solarslurpi/GrowBuddies/README.md

# GrowBuddies
[Documentation Location](https://growbuddies.readthedocs.io/en/latest/)
