solarslurpi/GrowBuddies/drafts-docs in progress/notes.md

info: profile set to 'default'
info: default host triple is armv7-unknown-linux-gnueabihf
info: syncing channel updates for 'stable-armv7-unknown-linux-gnueabihf'
info: latest update on 2022-11-03, rust version 1.65.0 (897e37553 2022-11-02)
info: downloading component 'cargo'
info: downloading component 'clippy'
info: downloading component 'rust-docs'
 18.8 MiB /  18.8 MiB (100 %)  10.6 MiB/s in  3s ETA:  0s
info: downloading component 'rust-std'
 27.3 MiB /  27.3 MiB (100 %)  10.1 MiB/s in  3s ETA:  0s
info: downloading component 'rustc'
 79.0 MiB /  79.0 MiB (100 %)  10.6 MiB/s in  9s ETA:  0s
info: downloading component 'rustfmt'
info: installing component 'cargo'
  6.1 MiB /   6.1 MiB (100 %)   5.7 MiB/s in  1s ETA:  0s
info: installing component 'clippy'
info: installing component 'rust-docs'
 18.8 MiB /  18.8 MiB (100 %)   1.4 MiB/s in 19s ETA:  0s
info: installing component 'rust-std'
 27.3 MiB /  27.3 MiB (100 %)   5.3 MiB/s in  6s ETA:  0s
info: installing component 'rustc'
 79.0 MiB /  79.0 MiB (100 %)   5.7 MiB/s in 14s ETA:  0s
info: installing component 'rustfmt'
info: default toolchain set to 'stable-armv7-unknown-linux-gnueabihf'

  stable-armv7-unknown-linux-gnueabihf installed - rustc 1.65.0 (897e37553 2022-11-02)

Rust is installed now. Great!

To get started you may need to restart your current shell.
This would reload your PATH environment variable to include
Cargo's bin directory ($HOME/.cargo/bin).

To configure your current shell, run:
source "$HOME/.cargo/env"
