solarslurpi/GrowBuddies/docs/images/after_grow_additives.jpg

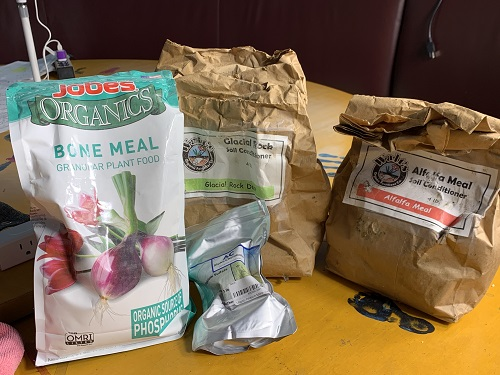
docs/images/after_grow_additives.jpg
