solarslurpi/GrowBuddies/docs/images/aliexpress12headmister.jpg

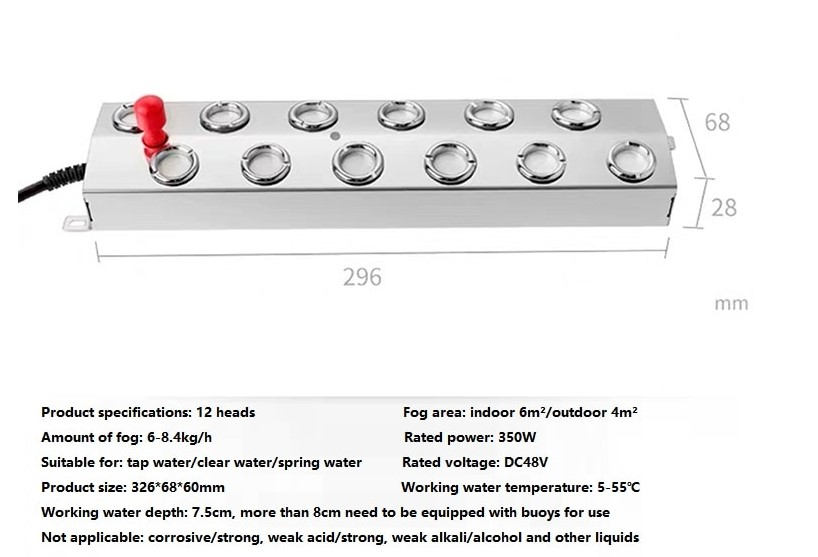
docs/images/aliexpress12headmister.jpg
