solarslurpi/GrowBuddies/docs/images/dragonfly.png

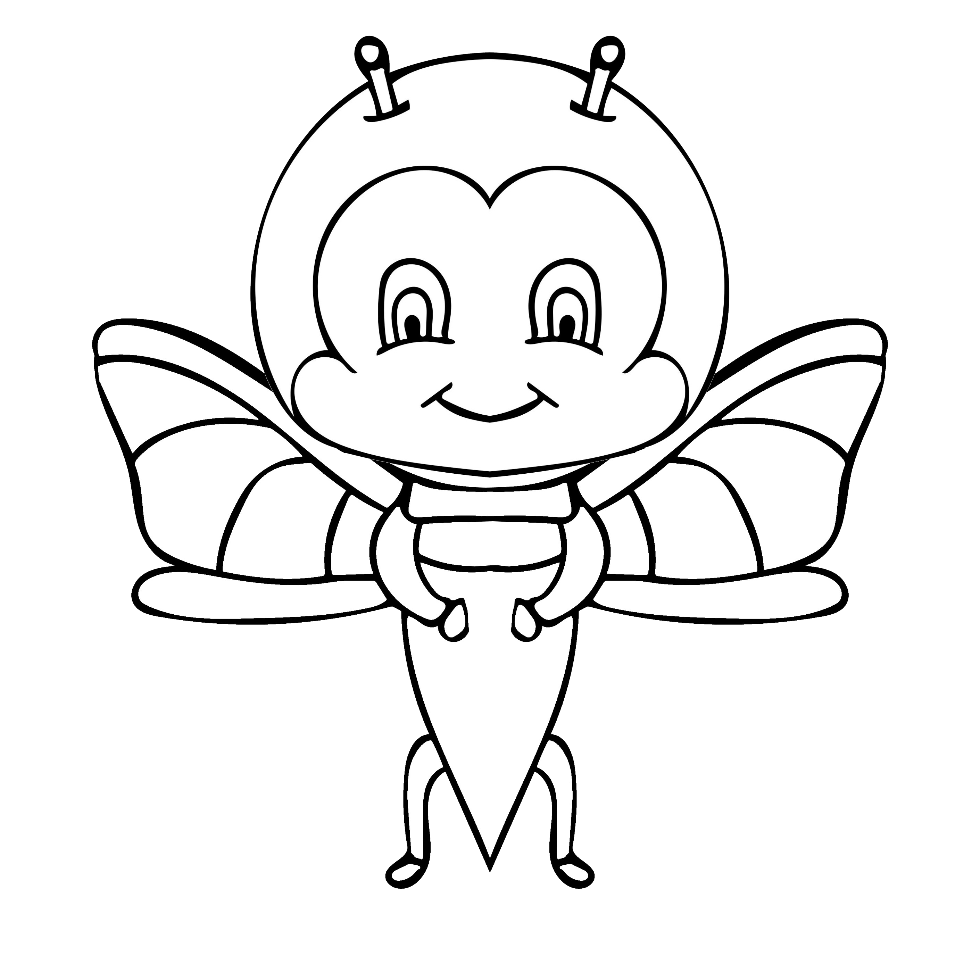
docs/images/dragonfly.png
