solarslurpi/GrowBuddies/docs/images/grafana_add_datasource.jpg

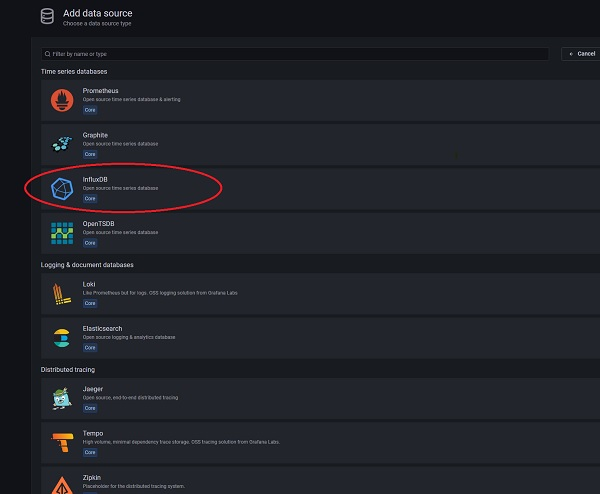
docs/images/grafana_add_datasource.jpg
