solarslurpi/GrowBuddies/docs/images/grafana_influxdb_http_config.jpg

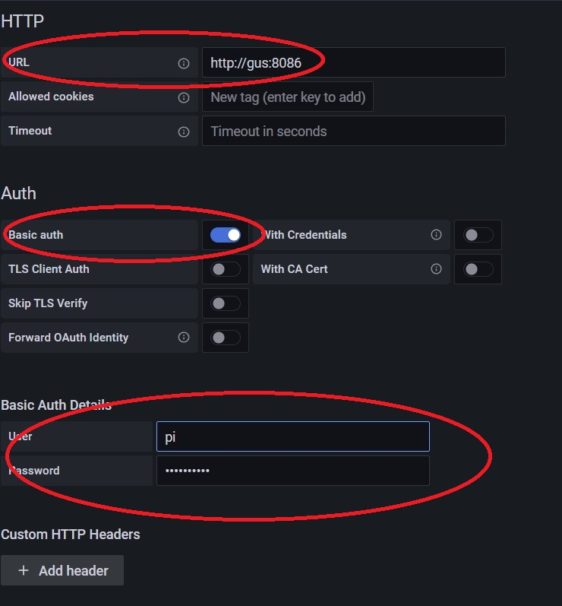
docs/images/grafana_influxdb_http_config.jpg
