solarslurpi/GrowBuddies/docs/images/grafana_influxdb_influxdb_config.jpg

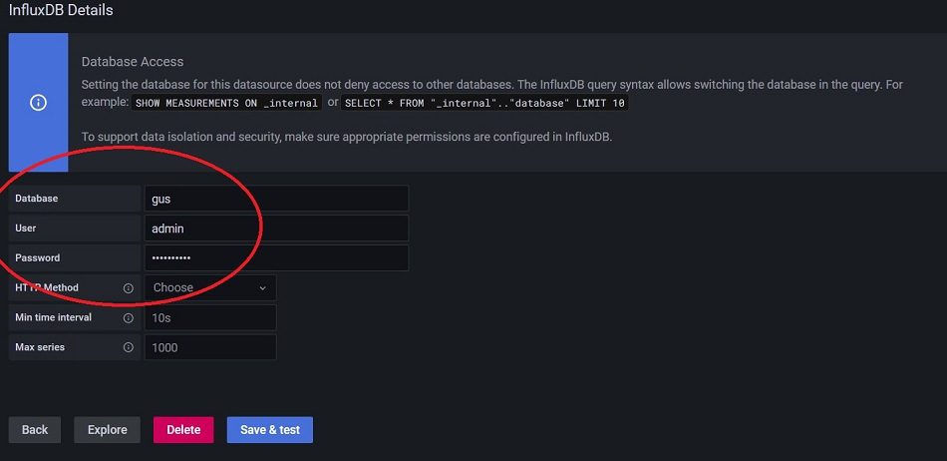
docs/images/grafana_influxdb_influxdb_config.jpg
