solarslurpi/GrowBuddies/docs/images/grafana_new_dashboard.jpg

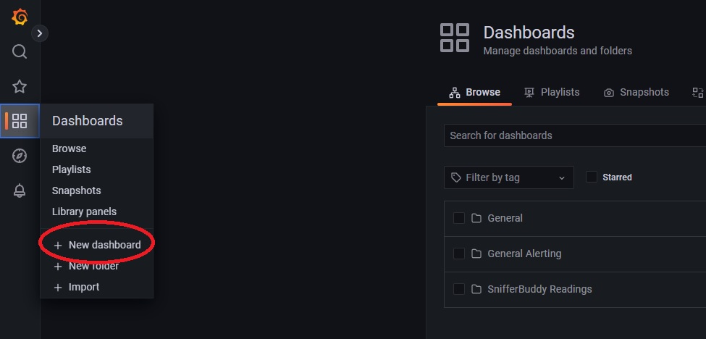
docs/images/grafana_new_dashboard.jpg
