solarslurpi/GrowBuddies/docs/images/grafana_snifferbuddyreadings_vpd._and_temp.jpg

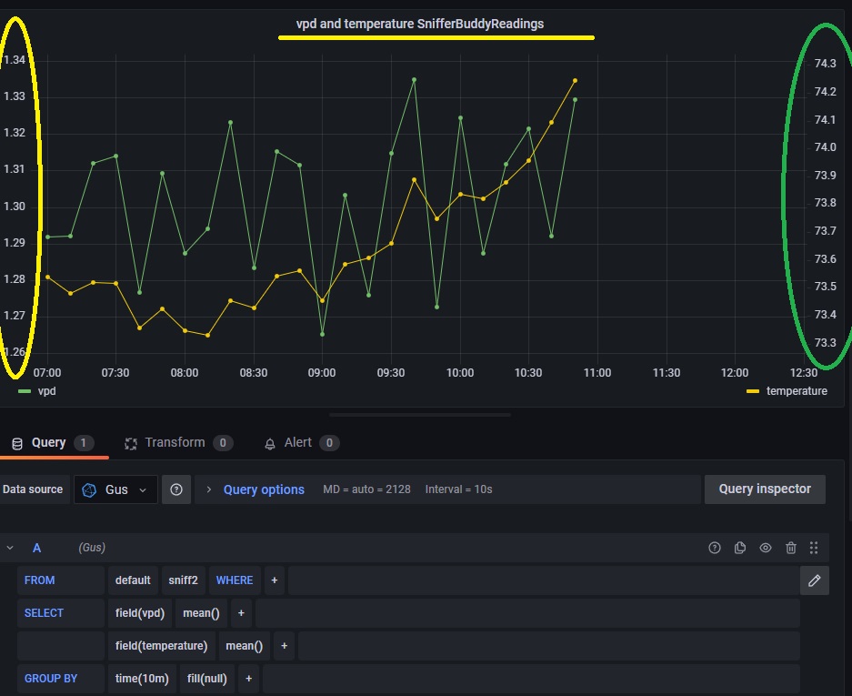
docs/images/grafana_snifferbuddyreadings_vpd._and_temp.jpg
