solarslurpi/GrowBuddies/docs/images/grafana_snifferbuddyreadings_vpd.jpg

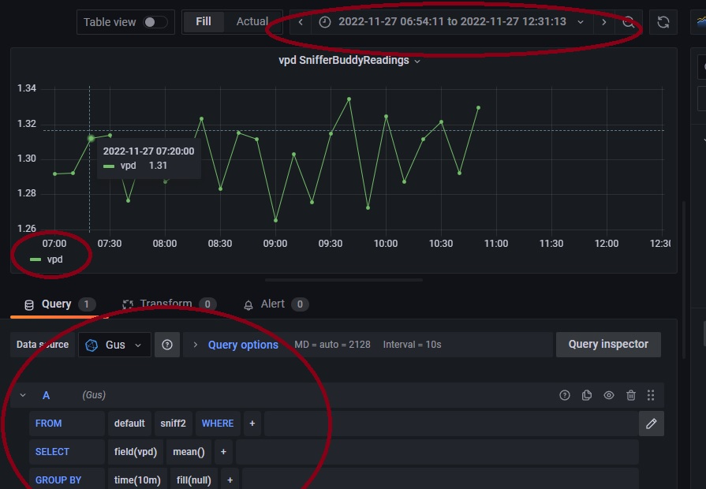
docs/images/grafana_snifferbuddyreadings_vpd.jpg
