solarslurpi/GrowBuddies/docs/images/hamster.jpg

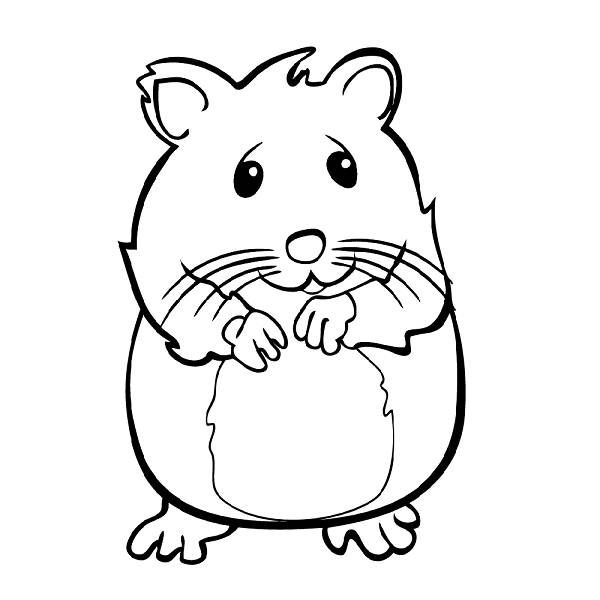
docs/images/hamster.jpg
