solarslurpi/GrowBuddies/docs/images/humidifier.jpeg

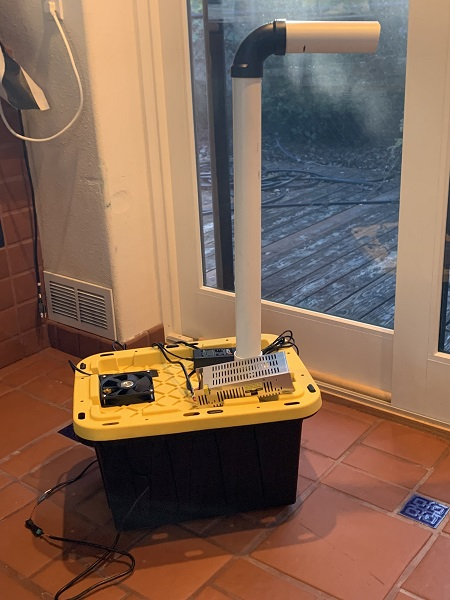
docs/images/humidifier.jpeg
