solarslurpi/GrowBuddies/docs/images/jobwelldone.jpg

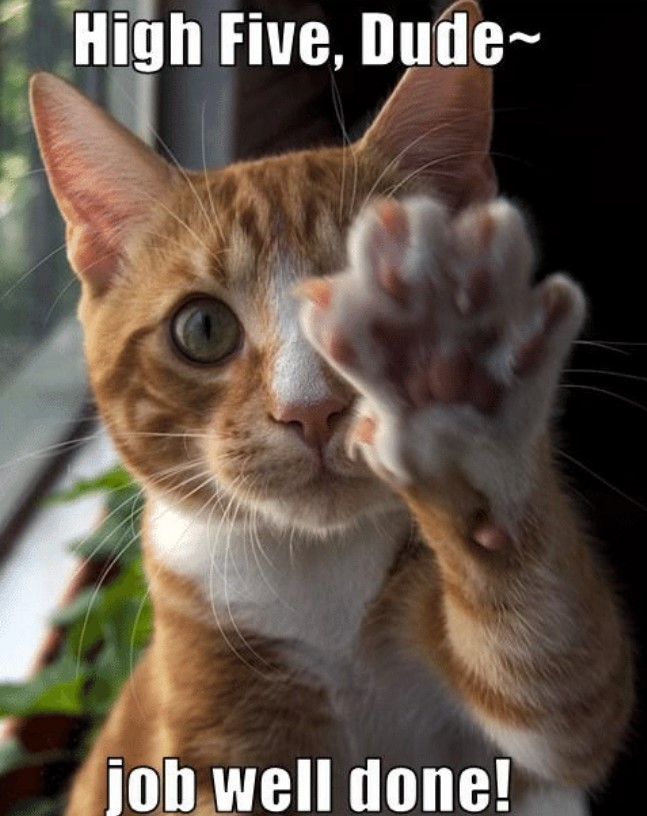
docs/images/jobwelldone.jpg
