solarslurpi/GrowBuddies/docs/images/MistBuddy_inside.jpeg

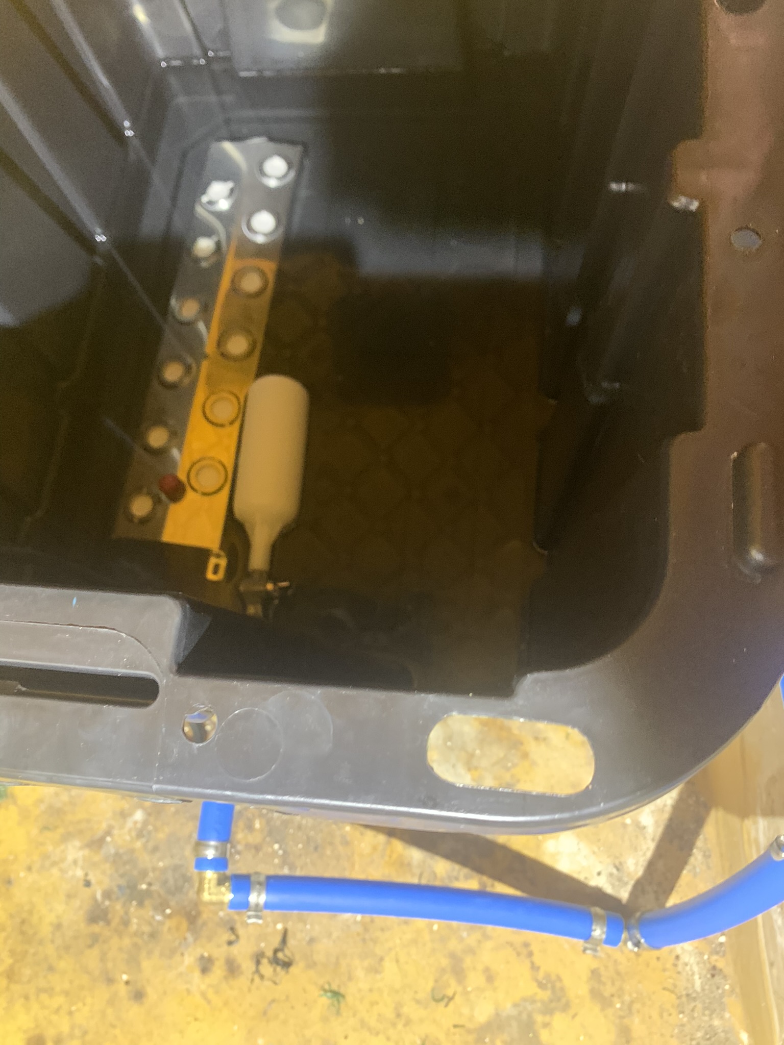
docs/images/MistBuddy_inside.jpeg
