solarslurpi/GrowBuddies/docs/images/mister_water_level.jpg

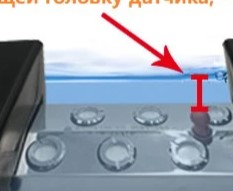
docs/images/mister_water_level.jpg
