solarslurpi/GrowBuddies/docs/images/plantvillage_classes_wheretofind.jpg

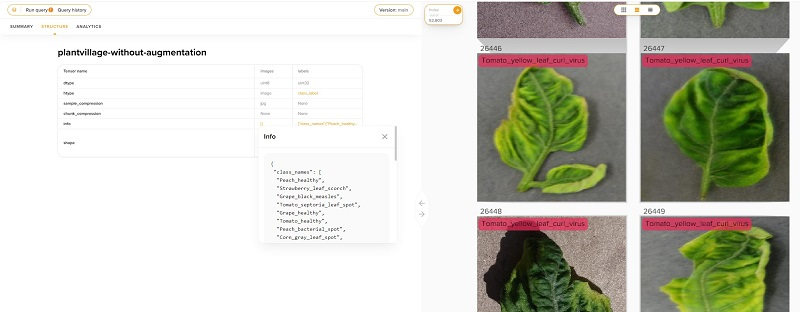
docs/images/plantvillage_classes_wheretofind.jpg
