solarslurpi/GrowBuddies/docs/images/power__supply.jpeg

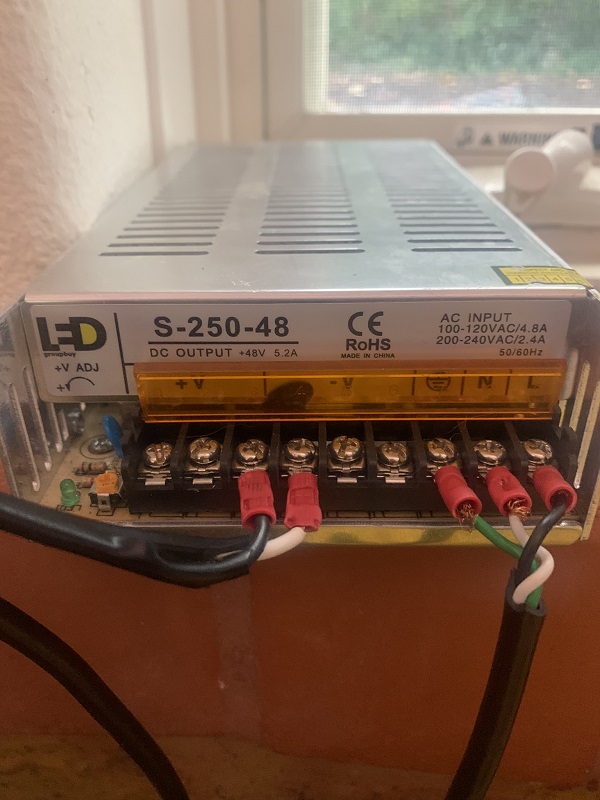
docs/images/power__supply.jpeg
