solarslurpi/GrowBuddies/docs/images/snifferbuddy_scd40_enclosure.jpg

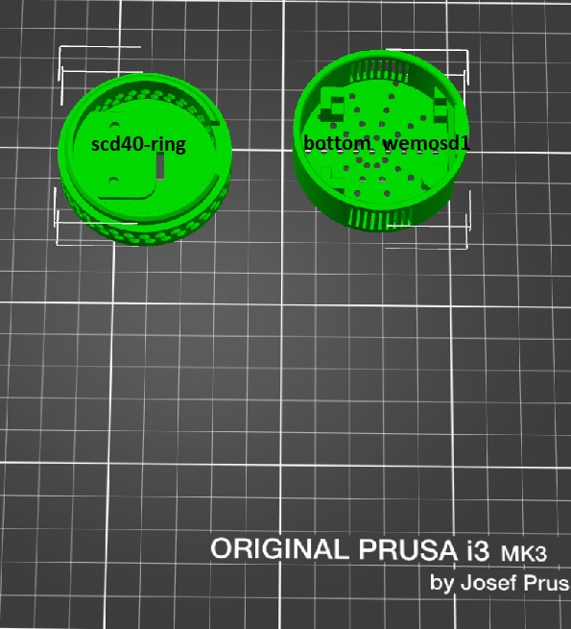
docs/images/snifferbuddy_scd40_enclosure.jpg
