solarslurpi/GrowBuddies/docs/images/snifferbuddy_scd40_inaction.jpg

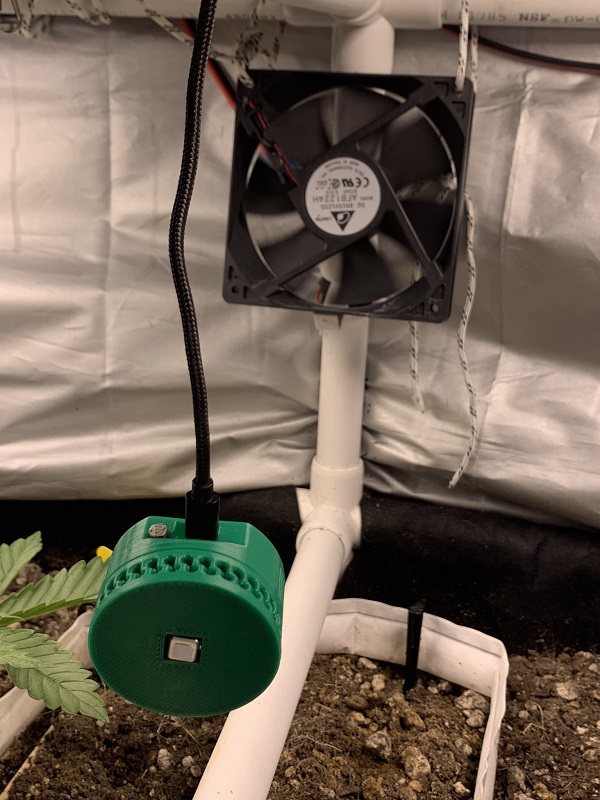
docs/images/snifferbuddy_scd40_inaction.jpg
