solarslurpi/GrowBuddies/docs/images/snifferbuddy_parts_on_printer_plate.jpg

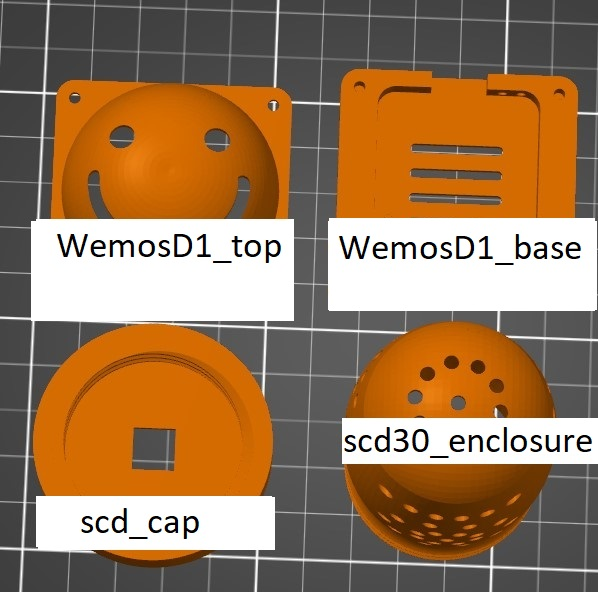
docs/images/snifferbuddy_parts_on_printer_plate.jpg
