solarslurpi/GrowBuddies/3D_prints/Gus/Pi4_Top_Hex_MM2_Color1.stl

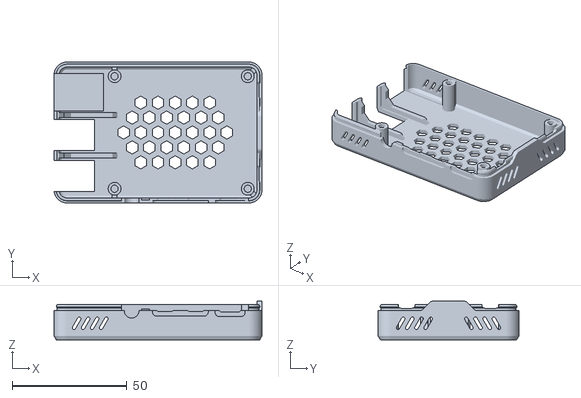
[picture p55: CAD file, 2022-10-26]
3D_prints/Gus/Pi4_Top_Hex_MM2_Color1.stl
90.6 x 61.4 x 16.9
