solarslurpi/GrowBuddies/3D_prints/PC Fan Holder/post (PART 2) v3.3mf

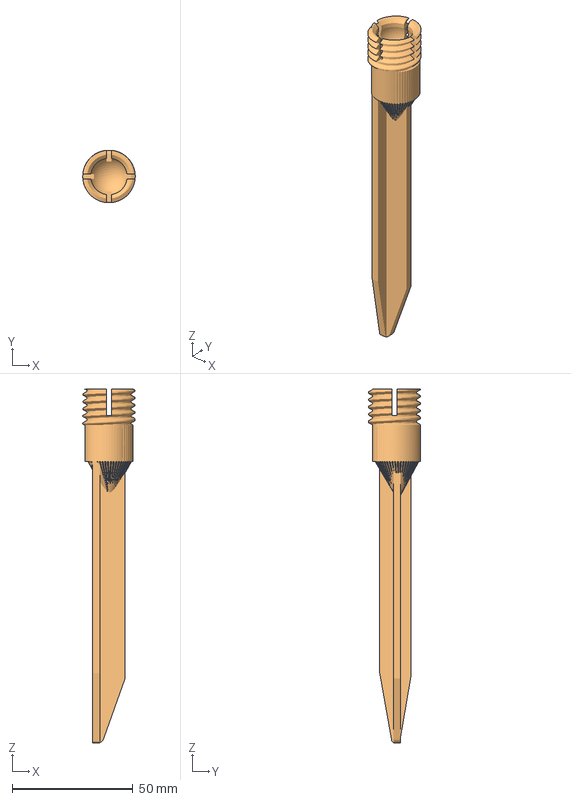
[picture p56: CAD file, 2024-07-01]
3D_prints/PC Fan Holder/post (PART 2) v3.3mf
21.8 x 21.8 x 146.8 mm
post-PART_2
tent post
