solarslurpi/GrowBuddies/3D_prints/SnifferBuddy/scd-30/wemosD1_base.3mf

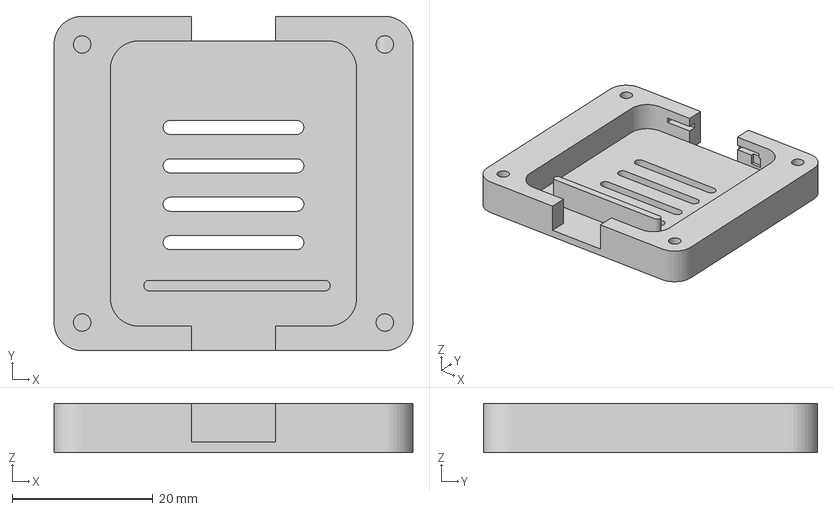
[picture p57: CAD file, 2022-10-20]
3D_prints/SnifferBuddy/scd-30/wemosD1_base.3mf
51.0 x 47.5 x 7.00 mm
