solarslurpi/GrowBuddies/3D_prints/SnifferBuddy/scd-40/wemos_bottom.3mf

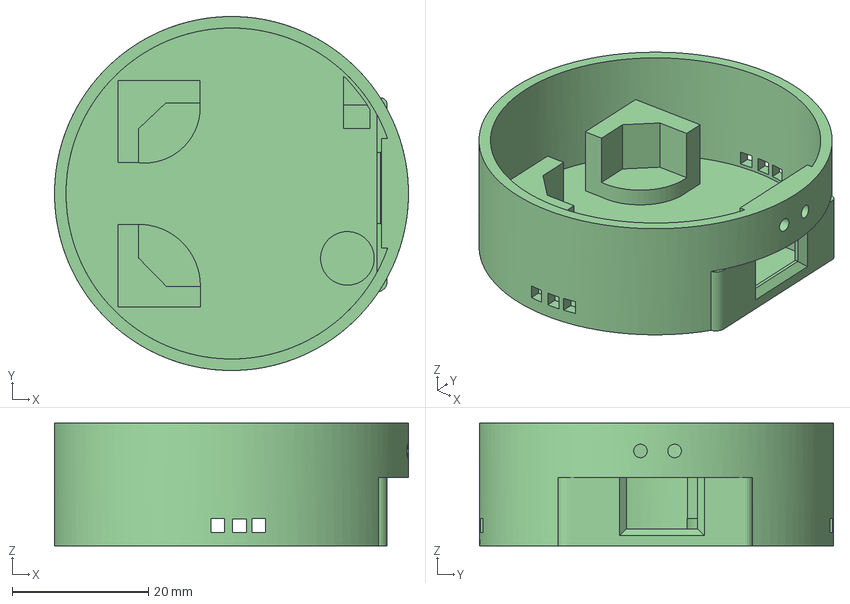
[picture p58: CAD file, 2023-11-12]
3D_prints/SnifferBuddy/scd-40/wemos_bottom.3mf
51.9 x 51.9 x 18.0 mm
