solarslurpi/GrowBuddies/3D_prints/Gus/Pi4_Top_Hex_MM2_Color2.stl

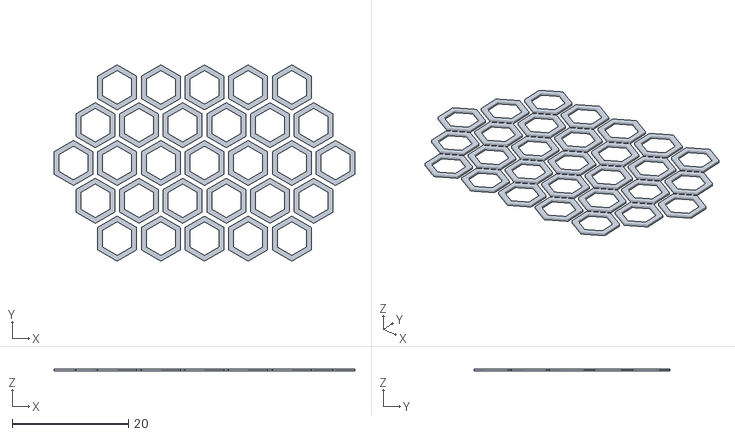
[picture p59: CAD file, 2022-10-26]
3D_prints/Gus/Pi4_Top_Hex_MM2_Color2.stl
51.7 x 33.7 x 0.4
