solarslurpi/GrowBuddies/3D_prints/SnifferBuddy/scd-30/scd_cap.3mf

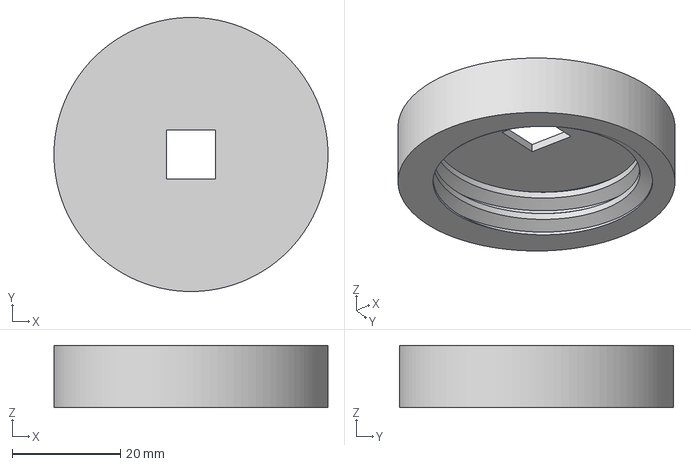
[picture p60: CAD file, 2022-10-19]
3D_prints/SnifferBuddy/scd-30/scd_cap.3mf
50.7 x 50.7 x 11.5 mm
