solarslurpi/GrowBuddies/3D_prints/Gus/Pi4_Bottom_Slots_SM.stl

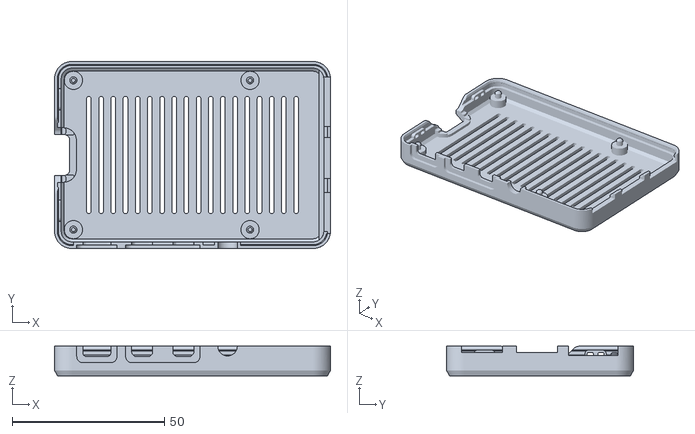
[picture p61: CAD file, 2022-10-26]
3D_prints/Gus/Pi4_Bottom_Slots_SM.stl
90.6 x 61.4 x 9.70
