solarslurpi/GrowBuddies/3D_prints/PC Fan Holder/fan_holder (PART 1) v2.3mf

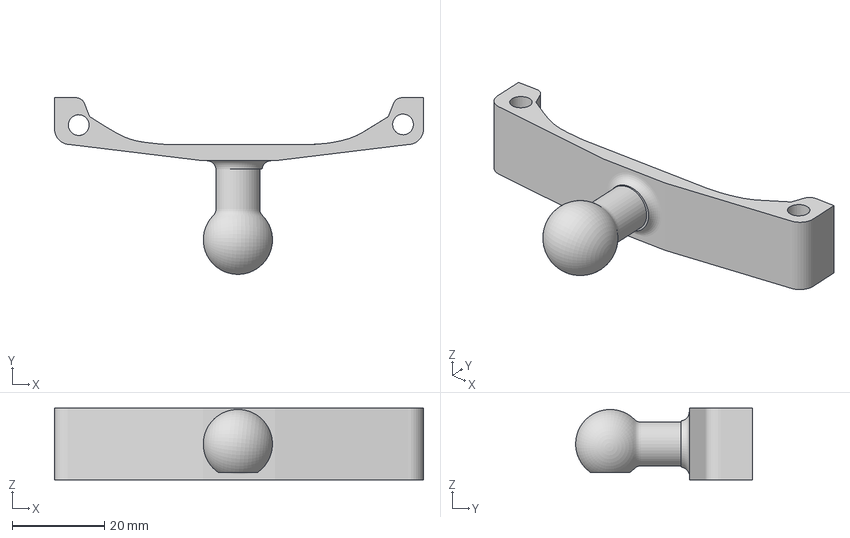
[picture p62: CAD file, 2024-07-01]
3D_prints/PC Fan Holder/fan_holder (PART 1) v2.3mf
80.0 x 38.3 x 15.5 mm
