solarslurpi/GrowBuddies/3D_prints/SnifferBuddy/scd-30/WemosD1_top.stl

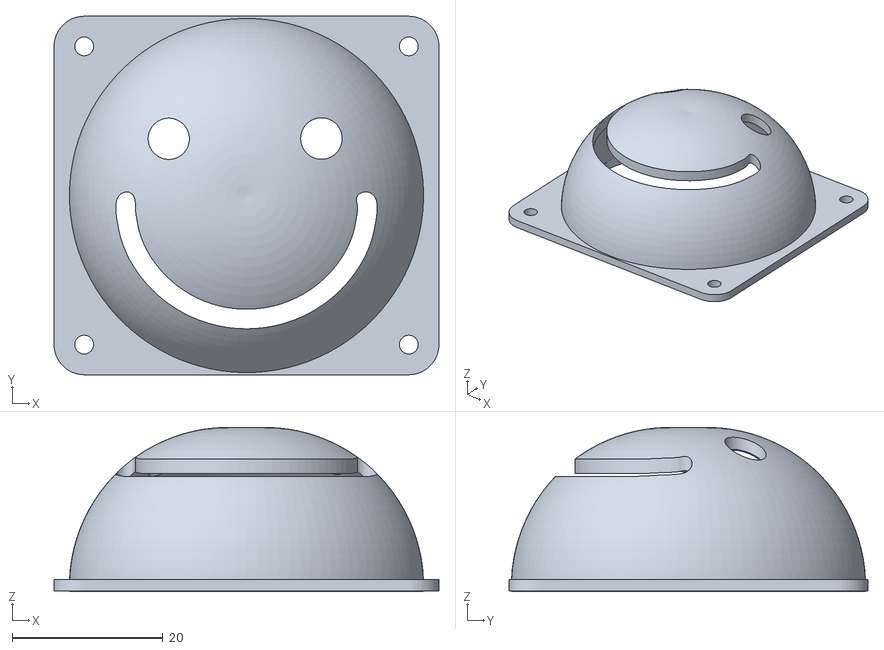
[picture p63: CAD file, 2022-10-07]
3D_prints/SnifferBuddy/scd-30/WemosD1_top.stl
51.0 x 47.5 x 21.8
