solarslurpi/GrowBuddies/3D_prints/Gus/Pi3_Top_Hex_MM2_Color1.stl

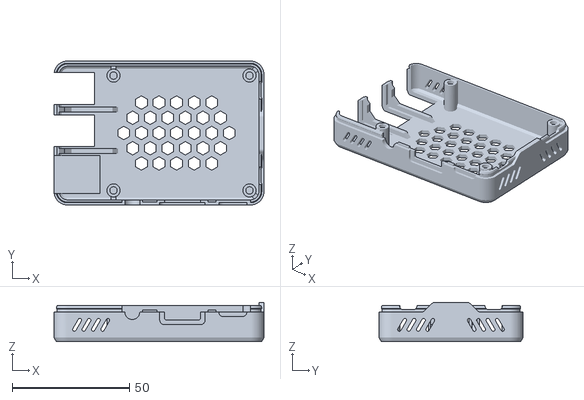
[picture p64: CAD file, 2022-10-25]
3D_prints/Gus/Pi3_Top_Hex_MM2_Color1.stl
89.6 x 61.4 x 16.9
