solarslurpi/GrowBuddies/3D_prints/SnifferBuddy/scd-30/scd30 enclosure.stl

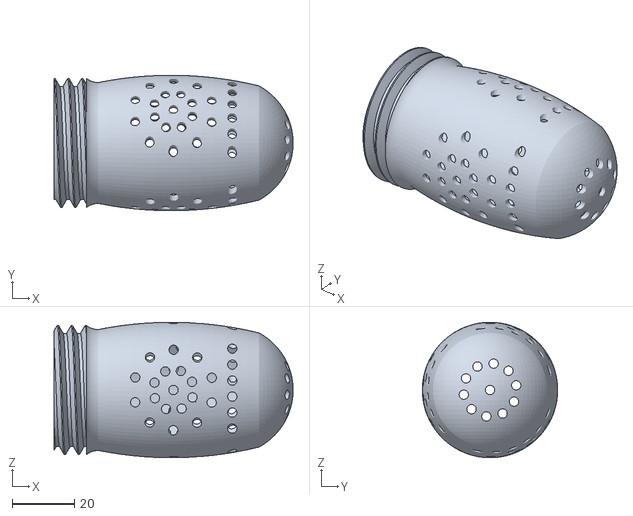
[picture p65: CAD file, 2022-10-07]
3D_prints/SnifferBuddy/scd-30/scd30 enclosure.stl
77.0 x 43.6 x 43.6
