solarslurpi/GrowBuddies/3D_prints/Gus/PI3_Bottom_Slots_SM.stl

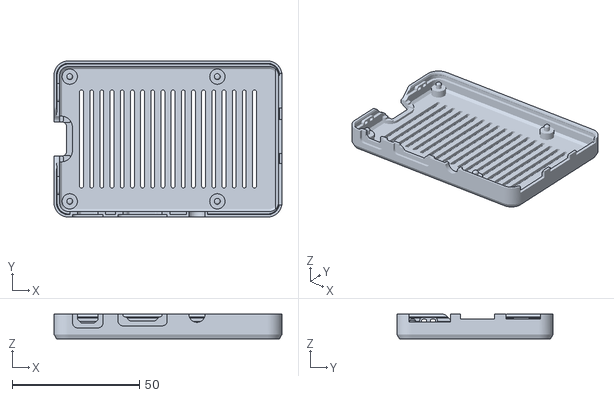
[picture p66: CAD file, 2022-10-25]
3D_prints/Gus/PI3_Bottom_Slots_SM.stl
89.6 x 61.4 x 9.70
