solarslurpi/GrowBuddies/3D_prints/PC Fan Holder/Nut (Part3).stl

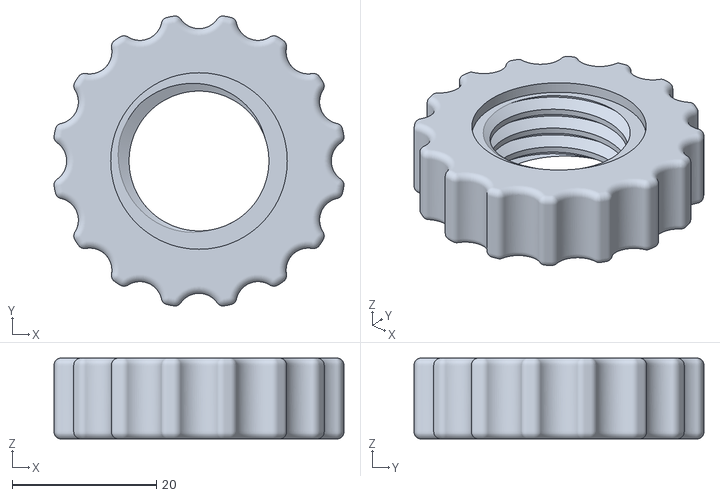
[picture p67: CAD file, 2024-07-01]
3D_prints/PC Fan Holder/Nut (Part3).stl
40.2 x 40.2 x 11.2
