solarslurpi/GrowBuddies/(list of files, cad)

Other CAD files:
3D_prints/Gus/Pi3_Top_Hex_MM2_Color2.stl
3D_prints/PC Fan Holder/fan_holder (PART 1) v2.f3d
3D_prints/SnifferBuddy/scd-30/WemosD1_base v2.f3z
3D_prints/SnifferBuddy/scd-30/WemosD1_top v1.f3d
3D_prints/SnifferBuddy/scd-30/_Wemos.8a6fa8fd-bdae-4608-9551-e9ac450bc9c8.f3d
3D_prints/SnifferBuddy/scd-30/scd cap v11.f3d
3D_prints/SnifferBuddy/scd-30/scd30 enclosure v1.f3d
3D_prints/SnifferBuddy/scd-40/wemos_top_v8.f3z
