solarslurpi/GrowBuddies/docs/images/snifferbuddy_scd40_wiring.jpg

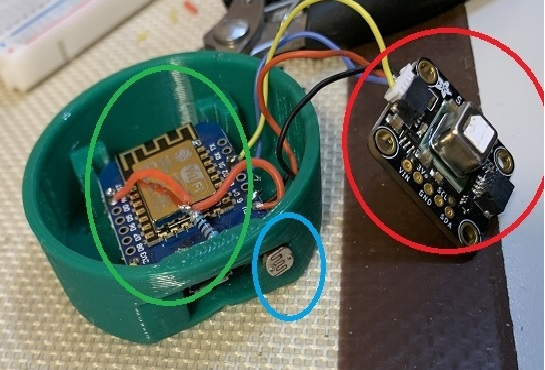
docs/images/snifferbuddy_scd40_wiring.jpg
