solarslurpi/GrowBuddies/growbuddiesproject/growbuddies/service_files/co2_tuning.csv

name | time | co2
co2_tuning | 1681327264873292426 | 1064
co2_tuning | 1681327294798611277 | 1015
co2_tuning | 1681327324829693850 | 925
co2_tuning | 1681327354812095681 | 950
co2_tuning | 1681327385077169976 | 1135
co2_tuning | 1681327414812701039 | 1177
co2_tuning | 1681327445021163627 | 1141
co2_tuning | 1681327474568743455 | 1074
co2_tuning | 1681327505001476845 | 969
co2_tuning | 1681327534799673376 | 883
co2_tuning | 1681327565017175346 | 849
co2_tuning | 1681327594842340758 | 763
co2_tuning | 1681327624821802002 | 739
co2_tuning | 1681327654767465010 | 724
co2_tuning | 1681327685017830676 | 707
co2_tuning | 1681327714824717395 | 730
co2_tuning | 1681327744781420928 | 674
co2_tuning | 1681327774570264674 | 678
co2_tuning | 1681327804795406670 | 695
co2_tuning | 1681327834564696316 | 745
co2_tuning | 1681327864796853379 | 863
co2_tuning | 1681327894930225467 | 1089
co2_tuning | 1681327924877700299 | 1115
co2_tuning | 1681327954884128572 | 1070
co2_tuning | 1681327984778132354 | 981
co2_tuning | 1681328014784849310 | 943
co2_tuning | 1681328045051205069 | 934
co2_tuning | 1681328074860957285 | 1072
co2_tuning | 1681328105077972155 | 1084
co2_tuning | 1681328134981905726 | 1005
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
