solarslurpi/GrowBuddies/docs/images/grafana_influxdb_data_test_worked.jpg

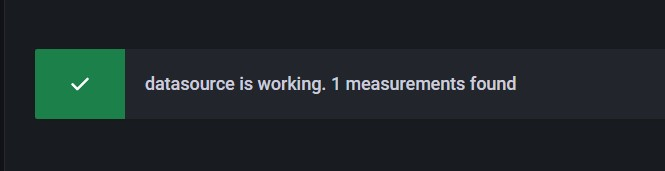
docs/images/grafana_influxdb_data_test_worked.jpg
