solarslurpi/GrowBuddies/(threads)

Thread 4 (2024-02-28):

PAR  and PPFF

latonita, 2024-02-28:
Hi, did you manage to calculate PAR and PPFD based on sensor AS7343 data?

clort81, 2024-07-08:
Been perusing the archive.org of his par_buddy and it looked pretty promising, really.
The 7343 could be a sensor that would yield a winner meter.
https://github.com/solarslurpi/GrowBuddy/blob/main/pages/PAR_Buddy.md

What happened to your jupyter notebooks and collected data solarslurpi?

It might also be possible to take a single diode LED and nook it up in some kind of standardized enclosure to calibrate vs the published spectrum.
