solarslurpi/GrowBuddies/(commit log)

2022-10-01 finished section on wiring.
2022-10-01 finished wiring section.
2022-10-01 evolved .
    [GrowBuddyParams.csv, base and lid v14.f3d, scd30 enclosure v1.f3d]
2022-10-07 added stl files.
    [esp286mini_bottom_enclosure.stl, esp286mini_top_enclosure.stl, scd30 enclosure.stl]
2022-11-26 Deleted snifferbuddy_storereading.py, vpdbuddy_manage.service and printing.md
2022-12-03 cleaning up packaging (or perhaps not...hmmm...)
    [setupOG.cfg]
2022-12-25 manage vpd and dripbuddy calibration work.
2023-04-14 checking in after refactoring PID code
    [co2_data.csv, co2_data_1.csv, co2_tuning.csv, co2_tuning_after_1326.csv]
2023-10-05 big commit it has been awhile
    [bottom_qtpy V1 v22.f3z, bottom_qtpy.3mf, mock_readings.csv, output.csv, scd-40 ring v3.f3z, scd40-ring.3mf]
2023-10-26 working through snifferbuddy issues...
    [code.py]
2023-11-06 updated snifferbuddy enclosure
    [bottom_qtpy V1 v22.f3z, bottom_qtpy.3mf, scd-40 ring v3.f3z, scd40-ring.3mf, wemos_bottom.3mf, wemos_top_v8.f3z]
2024-06-30 added 90 mm pc fan holder
    [90_m_fan_holder_project.f3d, 90_mm_fan_holder.3mf]
2024-07-01 evolved the readme for the fan holder.
    [90_m_fan_holder_project.f3d, 90_mm_fan_holder.3mf, Nut (Part3).stl, fan_holder (PART 1) v2.3mf, fan_holder (PART 1) v2.f3d, post (PART 2) v3.3mf]
